G-Fernandws/Peixebinha/Program_Turbidez/Diagrama_Sensor_Turbidez.jpg

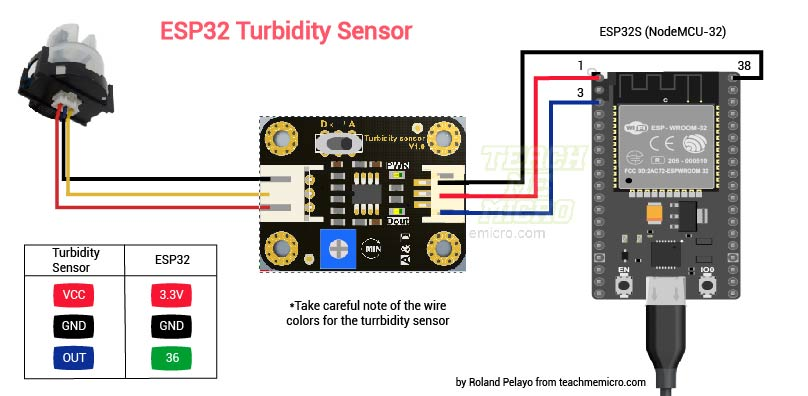
Program_Turbidez/Diagrama_Sensor_Turbidez.jpg
