G-Fernandws/Peixebinha/Arquivos/3d.jpeg

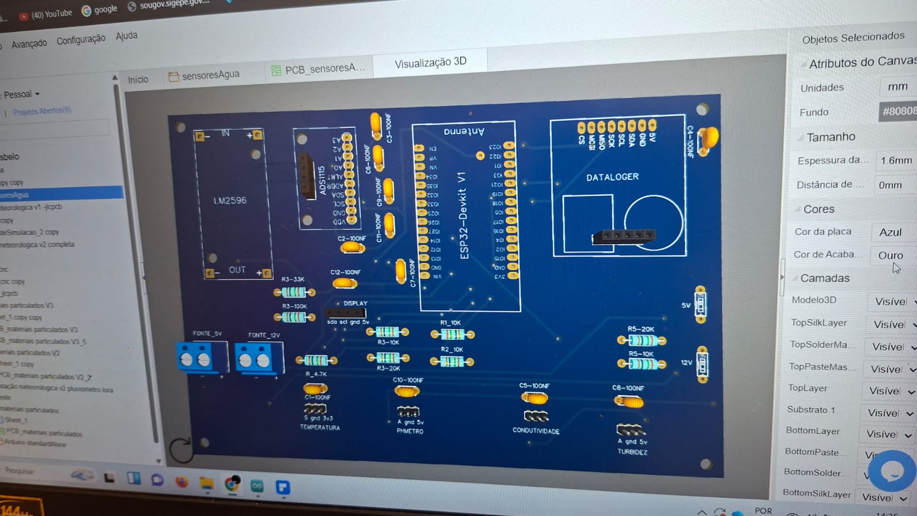
Arquivos/3d.jpeg
