G-Fernandws/Peixebinha/README.md

Repositório de programações do Peixebinha.
Sensores:

* pH;
* Condutividade Elétrica;
* Temperatura;
* Turbidímetro.

PINOS DOS SENSORES NA PROGRAMAÇÃO PRINCIPAL
 pH 						gpio 35

&nbsp;	Condutividade 	gpio 34

&nbsp;	Trubidez			gpio 26 (temporário)

&nbsp;	Nitrato			gpio 32

&nbsp;	Amônia			gpio 33 (temporário)

&nbsp;	Temperatura		gpio 4

PINAGEM ESP32 QUE ESTÁ SENDO USADO
Pinagem_ESP32
