G-Fernandws/Peixebinha/Program_Amonia/Infos.txt

| Ponto | Est. (1000 mg/L) | Água destilada | Volume final |
| --- | ---:  | ---: | ---: |
| 10 mg/L | 1,0 mL | 99,0 mL | 100 mL |
| 35 mg/L | 3,5 mL | 96,5 mL | 100 mL |
| 50 mg/L | 5,0 mL | 95,0 mL | 100 mL |
| 75 mg/L | 7,5 mL | 92,5 mL | 100 mL |
| 100 mg/L | 10,0 mL | 90,0 mL | 100 mL |
