G-Fernandws/Peixebinha/Program_Turbidez/v2.0.Program_Trubidez/INFOS.txt

Projeto interessante, leitura do sensor integrada com um aplicativo: https://www.teachmemicro.com/esp32-turbidity-sensor/
