G-Fernandws/Peixebinha/Arquivos/2d.jpeg

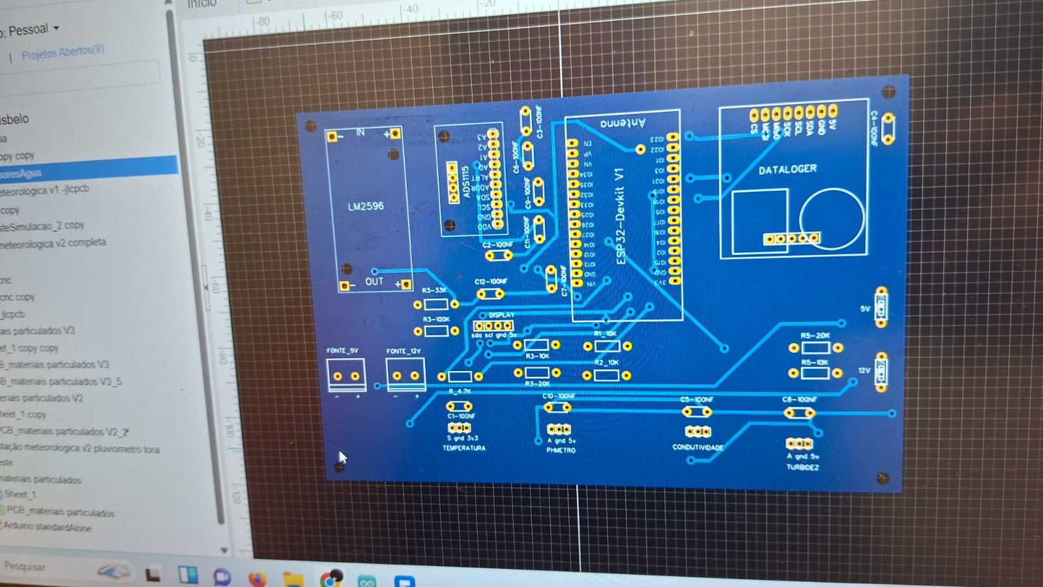
Arquivos/2d.jpeg
