G-Fernandws/Peixebinha/Arquivos/WhatsApp Image 2026-03-06 at 2.28.37 PM.jpeg

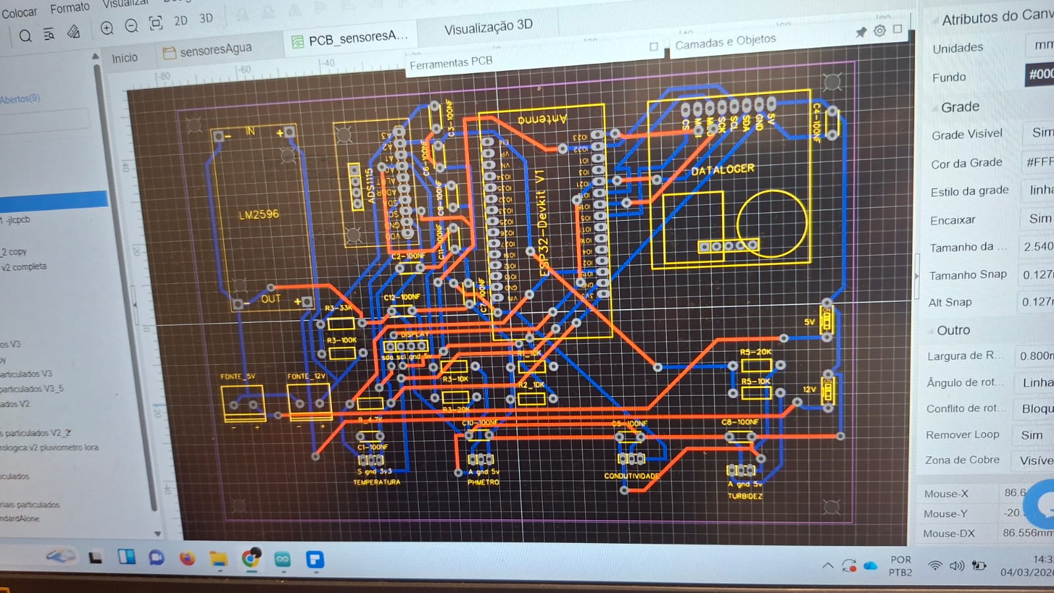
Arquivos/WhatsApp Image 2026-03-06 at 2.28.37 PM.jpeg
