G-Fernandws/Peixebinha/Program_pH/ESQUEMA-ph.png

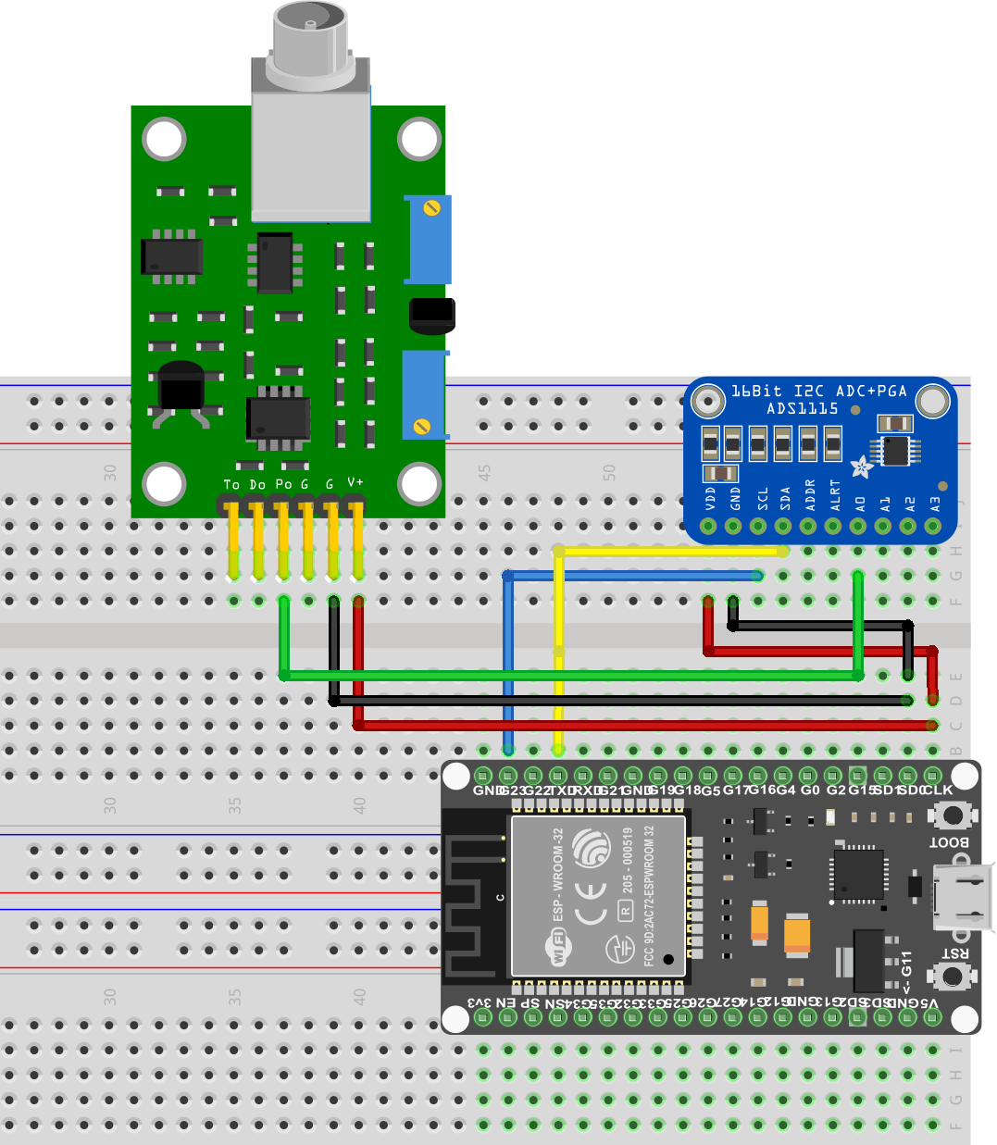
Program_pH/ESQUEMA-ph.png
