G-Fernandws/Peixebinha/Program_Temperatura/Diagrama_Sensor_Temp.png

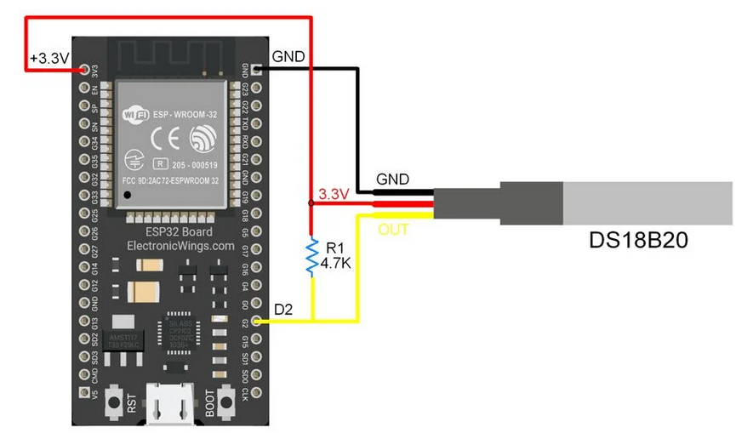
Program_Temperatura/Diagrama_Sensor_Temp.png
