G-Fernandws/Peixebinha/Program_Temperatura/Infos_Sensor_Temp.png

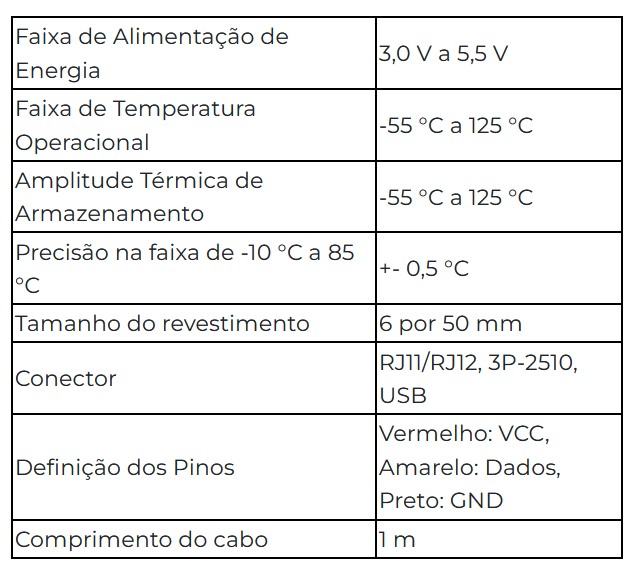
Program_Temperatura/Infos_Sensor_Temp.png
