G-Fernandws/Peixebinha/Program_Turbidez/Divisor_Tensao.png

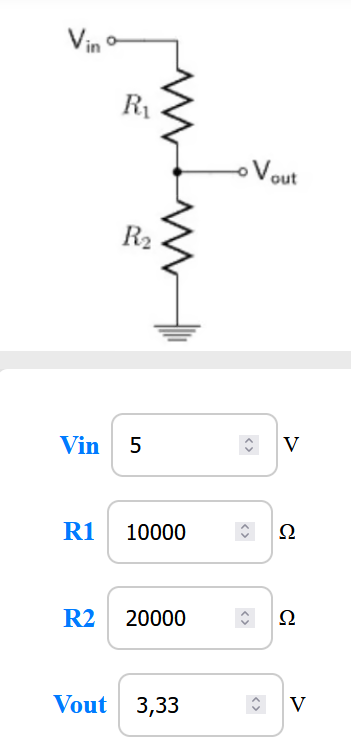
Program_Turbidez/Divisor_Tensao.png
