G-Fernandws/Peixebinha/(list of files, drawings)

Other design files:
Placa_Principal/Ge/SCH_Placa_Peixebinha_2026-07-04.json
Placa_Principal/Glaicon/PCB_PCB_sensoresAgua_2026-07-03.json
Placa_Principal/Glaicon/SCH_sensoresAgua_2026-07-03.json
