G-Fernandws/Peixebinha/(commit log)

2026-02-05 removendo pastas para reorganizar
2026-02-05 Teste de sincronização
2026-02-05 Adicionei pasta de programação do sensor de turbidez
2026-02-05 Adicionei pasta de programação do sensor de temperatura
2026-02-05 Adicionei pasta de programação do sensor de pH
2026-02-05 Adicionei pasta de programação do sensor de condutividade
2026-02-05 adicionei os pinos dos sensores README.md
2026-02-06 Adicionei a programação de calibração do sensor de condutividade
2026-02-06 Adicionei as programações de condutividade, calibração e já calibrado
2026-02-06 Atualizei a programação para usar no ESP32 e comentei mais
2026-02-06 Atualizei a programação do sensor de temperatura para uso no ESP32 e comentei mais também
2026-02-06 Adicionei o diagrama de montagem e as especificações do sensor de temperatura
2026-02-06 Adaptei para uso em ESP32 a proramação do sensor de turbidez e coloquei em uma pasta separada pois não está com calibração, quero testar uma outra versão
2026-02-06 Adicionei a programação que quero testar, o diagrama de montagem do sensor com o ESP32 e o diagrama do divisor de tensão
2026-02-06 adicionei um txt para infos que encontrei sobre o sensor
2026-02-06 Alterei os pinos do arduino para ESP32
2026-02-06 README.md
    Adicionei a pinagem do ESP32 que vai ser usado
2026-02-06 Alterei a programação para fazer uma calibração simples junto com as leituras: TESTAR!
2026-02-09 Mudança de pino para o ESP32
2026-02-09 Adaptações para o o ESP32
2026-03-04 Alterações nas programações de pH e Condutividade
2026-03-04 Atualização de parâmetros
2026-03-04 Nova programação de calibração e condutividade. Tabelas do resultado dos testes feitos no dia 04/03/2026
    [Dados_Condutividade_04-03.xlsx]
2026-03-13 Atualizei as programações de condutividade, agora tem apenas as que serão utilizadas.
2026-03-16 organizei melhor a pasta do sensor de pH
2026-03-18 Novas programações do sensor de pH e anotações sobre testes de calibração e validação'
2026-03-21 organização de arquivos
2026-03-27 Organizei a planilha de dados coletados da calibração do sensor de condutividade
    [Dados_Condutividade_04-03.xlsx]
2026-04-06 Melhorei a programação de calcular os coeficientes de calibração do sensor de pH
2026-04-06 Nova versão da programação de turbidez, adicionei a pasta do sensor de nitrato
2026-04-06 Adicionei programação de calibração e leitura do sensor de nitrato e adicionei programação principal com envio de dados para dashboard
2026-04-07 Corrigi programacao de calibração do sensor de nitrato, melhorei muito a programação principal
    [Calibracao_Mais_Bruta_UltimaUsada.ino, Calibracao_Nitrato.ino, Leitura_Tensao_Blocos.ino, Progam_Nitrato_v1.0.ino, Program_Principal_07-04-2026.ino]
2026-04-09 Adicionei a programação do sensor de amônia
2026-04-09 Conclui a programação do sensor de amonia
2026-05-21 Adicionei as programações de calibração dos sensores de nitrato e amonia segundo seus respectivos manuais e adicionei a programação de leitura completa do sensor de nitrato
2026-05-26 Adicionei programação de leitura de tensao do sensor de nitrato para achar o slope e a programação teste da curva de calibração
2026-07-04 Adicionei uma pasta da placa principal
    [PCB_PCB_sensoresAgua_2026-07-03.json, SCH_Placa_Peixebinha_2026-07-04.json, SCH_sensoresAgua_2026-07-03.json]
